funvit/toilet-fan-control.atmega328pb/(commit log)

2020-01-05 перепутал подписи к кнопкам + и -
2020-01-05 фикс схемы - добавлена подтяжка на землю транзистору
2020-01-12 неверные значения при отмене результата изменения значения в меню
    Это проявляется при первом запуске.
    Ибо в eeprom все забито как 0xff.
2020-02-06 изменение алгоритма работы 2 таймера
    По окончанию 1 таймера (появление света) теперь
    не запускается 2 таймер, а просто включается
    вентилирование в постоянном режиме.
    2 таймер теперь отвечает за длительность работы вытяжки
    при пропадании света.
2020-02-06 Revert "изменение алгоритма работы 2 таймера"
    This reverts commit 42664a210336aeb295ac023a1a64c828819bd4db.
    [fan_control_with_display.ino, storage.h]
2022-11-06 feat: screen saver
    Базовый функционал (без настроек).
    - Небольшой рефакторинг.
2022-11-06 обновлена версия (которая выводится на экран)
2022-11-06 обновлен readme
2022-11-06 добавлен комментарий к define
